dan-mills/microJect/injector driver 2/production/bom.csv

Designator | Footprint | Quantity | Value | LCSC Part #
C1, C19, C2, C20, C21, C3, C4, C5, C6, C7, C8 | 0603 | 11 | 1uF
C23, C25 | CP_Elec_5x5.7 | 2 | 22uF 35V
C27, C28, C34 | 0603 | 3 | 100nF
C29, C30, C31, C32 | 1206 | 4 | 10uF
C33 | 1206 | 1 | 10uF 50V
C9 | 1206 | 1 | 470pF 1kV
D10, D14, D4, D5, D6, D7, D8, D9 | 0603 | 8 | LED
D11, D12, D13, D15 | D_SOD-123 | 4 | B140HW-7
D16, D3 | SOT-23 | 2 | NUP2105L
IC3 | SOT89 | 1 | HT7533-1(SOT89)
IC4 | SOIC127P700X220-8N | 1 | ACPL-227-50BE
J1 | PHOENIX_1751109 | 1 | Conn_01x03_Socket
J10, J12, J7, J8, J9 | PHOENIX_1751099 | 5 | Conn_01x02_Pin
J2 | PinHeader_1x02_P2.54mm_Vertical | 1 | Conn_01x02
J3, J4 | PHOENIX_1751112 | 2 | Conn_01x04_Socket
J5 | PinHeader_1x06_P2.54mm_Vertical | 1 | Programming header
L3 | IND_MURATA-PS_4500 | 1 | 6.8uH
Q3, Q4, Q5, Q6 | SOT-23 | 4 | AO3400A
R1 | 1206 | 1 | 120R
R10, R11, R12, R15, R16, R19, R22, R28, R3, R4, R5, R6, R7, R8, R9 | 0603 | 15 | 10k
R17, R18 | 0603 | 2 | 4k7
R20, R21, R23, R29, R30, R31, R32 | 0603 | 7 | 1k
R27 | 0603 | 1 | 140k
SW1 | SW_DIPTRONICS_DHA-04TQ | 1 | Switch
TP1, TP2, TP3, TP4, TP5, TP6, TP7, TP8 | TestPoint_THTPad_2.5x2.5mm_Drill1.2mm | 8 | TestPoint
U1 | LQFP-32_7x7mm_P0.8mm | 1 | STM32F030K6Tx
U2 | Converter_DCDC_Murata_CRE1xxxxxx3C_THT | 1 | B2405S-1WR3
U4 | SOIC-16W_7.5x10.3mm_P1.27mm | 1 | ISO3082DW
U7 | SOT-583-8 | 1 | TPS62933
