dan-mills/microJect/injector driver 2/injector driver 2.kicad_pcb

## KiCad design injector driver 2/injector driver 2.kicad_pcb (2026-10-11)

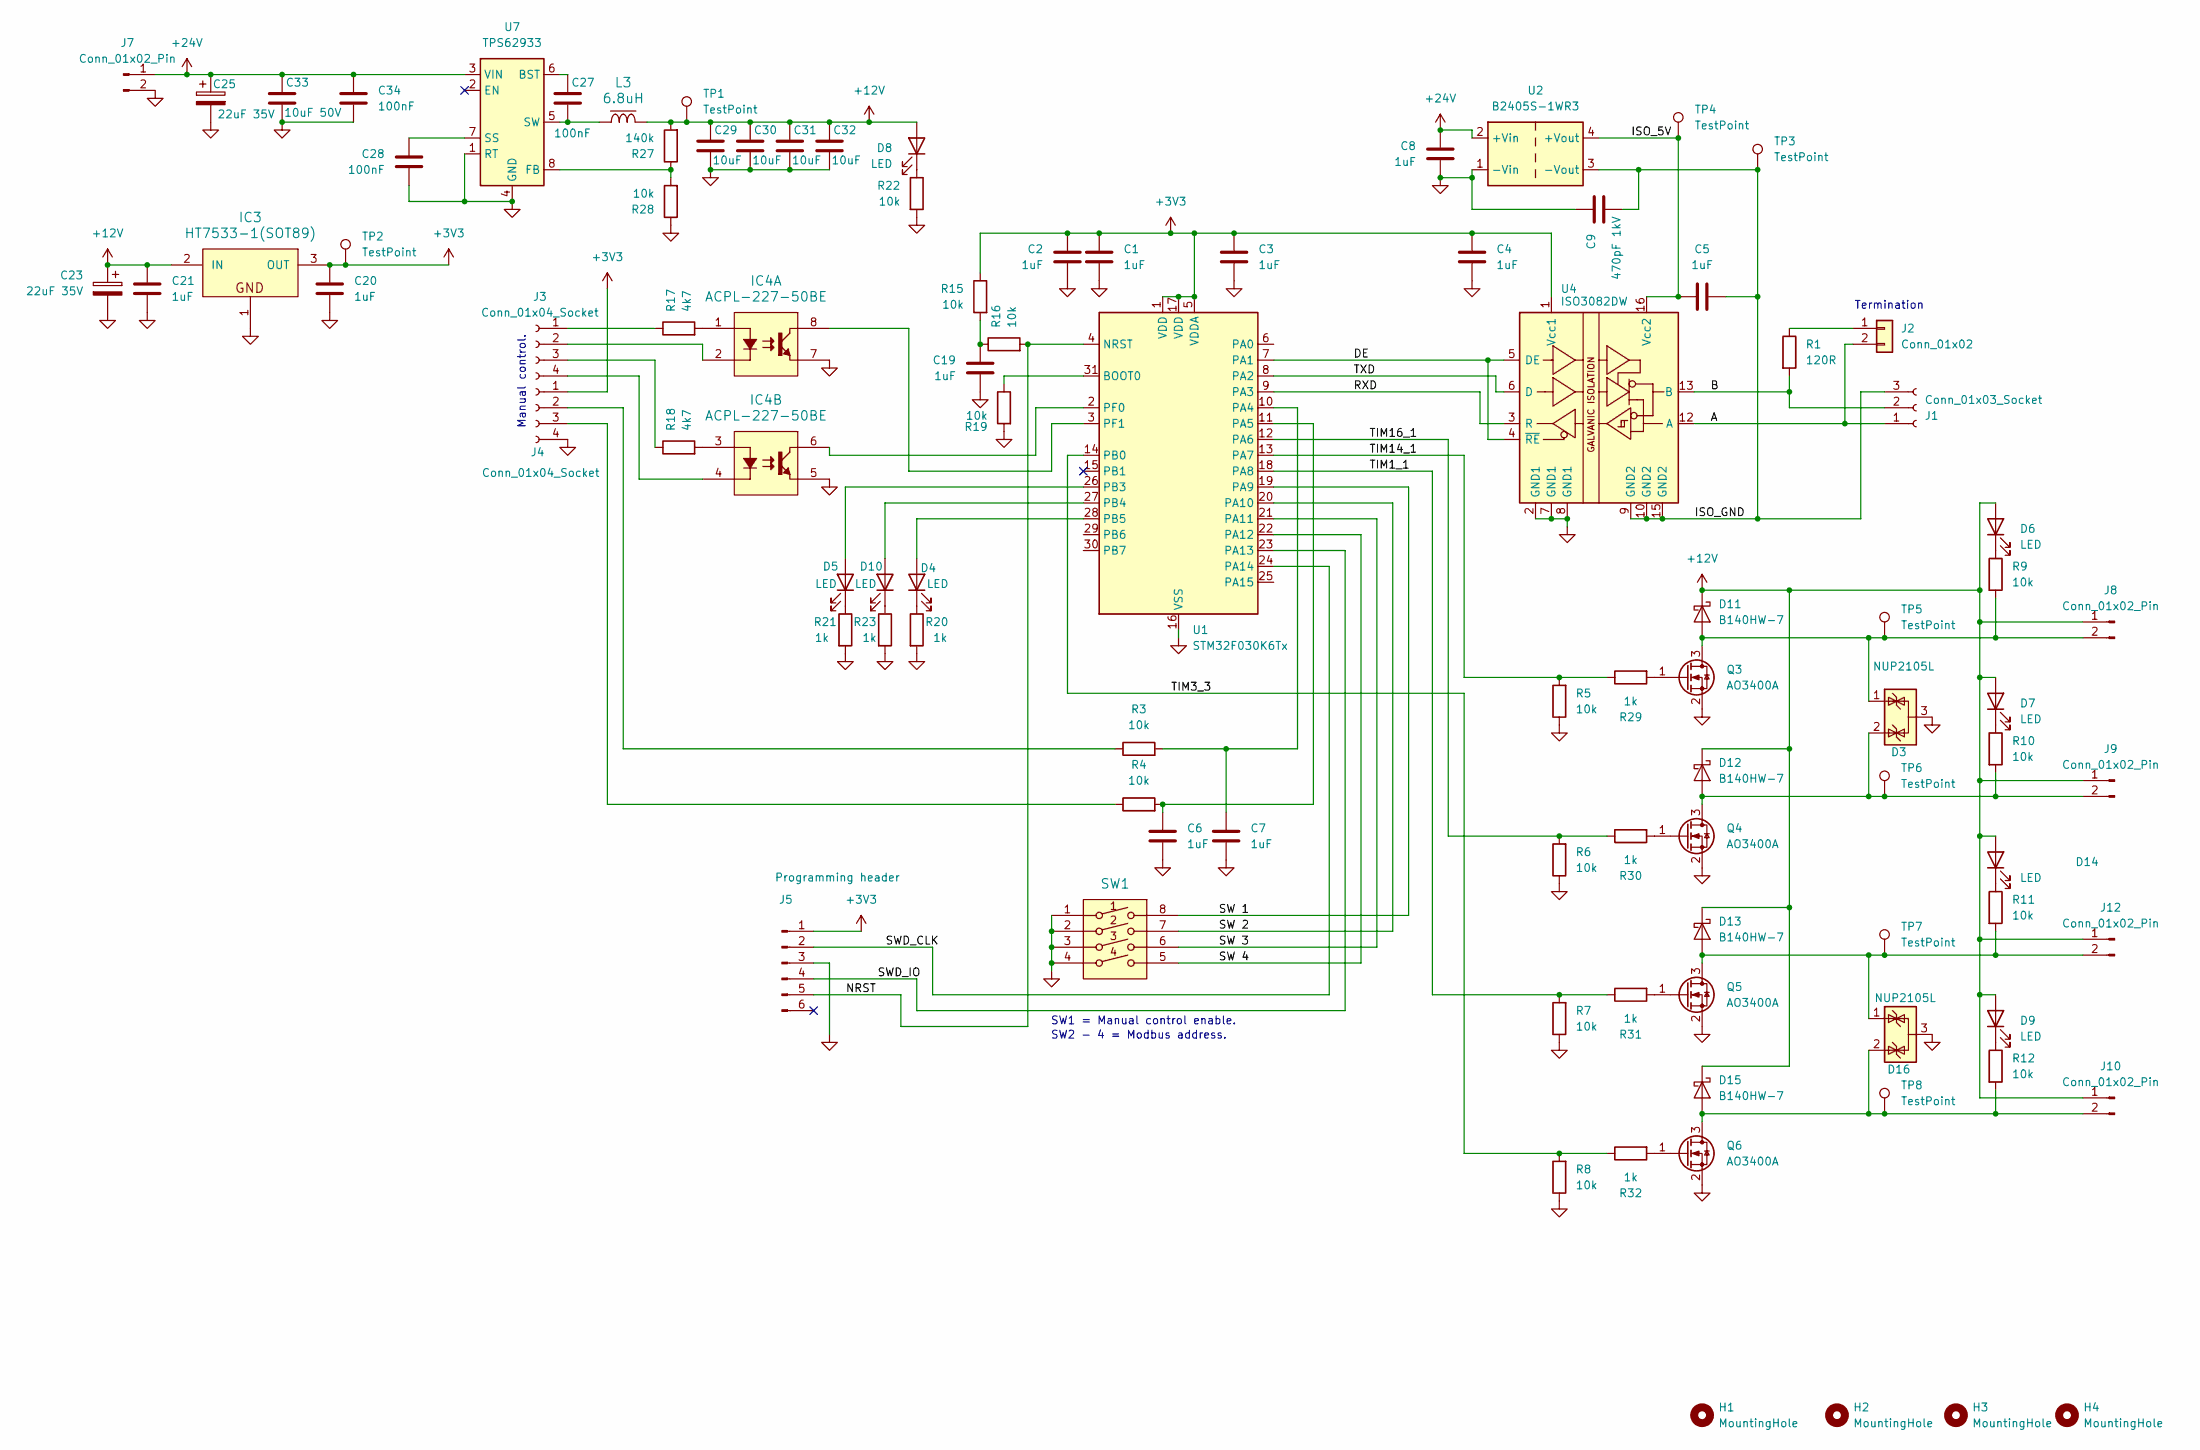
[picture p2: schematic injector driver 2.kicad_sch, Injector driver]

Parts:
C1, C2, C3, C4, C5, C6, C7, C8, C19, C20, C21: 1uF; C_0603_1608Metric
C9: 470pF 1kV; C_1206_3216Metric
C23, C25: 22uF 35V; CP_Elec_5x5.7
C27, C28, C34: 100nF; C_0603_1608Metric
C29, C30, C31, C32: 10uF; C_1206_3216Metric
C33: 10uF 50V; C_1206_3216Metric
D3, D16: NUP2105L; SOT-23
D4, D5, D6, D7, D8, D9, D10, D14: LED; LED_0603_1608Metric
D11, D12, D13, D15: B140HW-7; D_SOD-123; Part Number B140HW-7; JLCPCB ID C134429
H1, H2, H3, H4: MountingHole; MountingHole_3.2mm_M3_ISO14580_Pad
IC3: HT7533-1(SOT89); SOT89; Part Number HT7533-1(SOT89)
IC4: ACPL-227-50BE; SOIC127P700X220-8N; Part Description DC Input Dual Channel Half-Pitch Photot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
J1: Conn_01x03_Socket; PHOENIX_1751109
J2: Conn_01x02; PinHeader_1x02_P2.54mm_Vertical; Part Number 1-0201FBV0T
J3, J4: Conn_01x04_Socket; PHOENIX_1751112
J5: Programming header; PinHeader_1x06_P2.54mm_Vertical
J7, J8, J9, J10, J12: Conn_01x02_Pin; PHOENIX_1751099
L3: 6.8uH; IND_MURATA-PS_4500; Tolerance ±20%; Part Description Low Profile, High Current IHLP® Inductor
Q3, Q4, Q5, Q6: AO3400A; SOT-23
R1: 120R; R_1206_3216Metric
R3, R4, R5, R6, R7, R8, R9, R10, R11, R12, R15, R16, R19, R22, R28: 10k; R_0603_1608Metric
R17, R18: 4k7; R_0603_1608Metric
R20, R21, R23, R29, R30, R31, R32: 1k; R_0603_1608Metric
R27: 140k; R_0603_1608Metric
SW1: Switch; SW_DIPTRONICS_DHA-04TQ; Part Number SW_DIPTRONICS_DHA-04TQ
TP1, TP2, TP3, TP4, TP5, TP6, TP7, TP8: TestPoint; TestPoint_THTPad_2.5x2.5mm_Drill1.2mm
U1: STM32F030K6Tx; LQFP-32_7x7mm_P0.8mm
U2: B2405S-1WR3; Converter_DCDC_Murata_CRE1xxxxxx3C_THT
U4: ISO3082DW; SOIC-16W_7.5x10.3mm_P1.27mm
U7: TPS62933; SOT-583-8

Connections:
+3V3: C1.1, C2.1, C3.1, C4.1, C20.1, IC3.3 (OUT), J4.1, J5.1, R15.1, TP2.1 (1_1), U1.1 (VDD), U1.5 (VDDA), U1.17 (VDD), U4.1 (Vcc1)
+12V: C21.1, C23.1, C29.1, C30.1, C31.1, C32.1, D6.2 (A), D7.2 (A), D8.2 (A), D9.2 (A), D11.1 (K), D12.1 (K), D13.1 (K), D14.2 (A), D15.1 (K), IC3.2 (IN), J8.1, J9.1, J10.1, J12.1, L3.2, R27.2, TP1.1 (1_1)
+24V: C8.1, C25.1, C33.1, C34.1, J7.1, U2.2 (+Vin), U7.3 (VIN)
/A: J1.1, J2.2, U4.12 (A)
/B: J1.2, R1.2, U4.13 (B)
/DE: U1.7 (PA1), U4.4 (~RE), U4.5 (DE)
/ISO_5V: C5.1, TP4.1 (1_1), U2.4 (+Vout), U4.16 (Vcc2)
/ISO_GND: C5.2, C9.2, J1.3, TP3.1 (1_1), U2.3 (-Vout), U4.9 (GND2), U4.10 (GND2), U4.15 (GND2)
/NRST: J5.5, R16.2, U1.4 (NRST)
/RXD: U1.9 (PA3), U4.3 (R)
/SW 1: SW1.8, U1.19 (PA9)
/SW 2: SW1.7, U1.20 (PA10)
/SW 3: SW1.6, U1.21 (PA11)
/SW 4: SW1.5, U1.22 (PA12)
/SWD_CLK: J5.2, U1.24 (PA14)
/SWD_IO: J5.4, U1.23 (PA13)
/TIM1_1: R7.2, R31.1, U1.18 (PA8)
/TIM3_3: R8.2, R32.1, U1.14 (PB0)
/TIM14_1: R5.2, R29.1, U1.13 (PA7)
/TIM16_1: R6.2, R30.1, U1.12 (PA6)
/TXD: U1.8 (PA2), U4.6 (D)
GND: C1.2, C2.2, C3.2, C4.2, C6.2, C7.2, C8.2, C9.1, C19.2, C20.2, C21.2, C23.2, C25.2, C28.2, C29.2, C30.2, C31.2, C32.2, C33.2, C34.2, D3.3 (A), D16.3 (A), IC3.1 (GND), IC4.5 (E), IC4.7 (E), J4.4, J5.3, J7.2, Q3.2 (S), Q4.2 (S), Q5.2 (S), Q6.2 (S), R5.1, R6.1, R7.1, R8.1, R19.2, R20.2, R21.2, R22.2, R23.2, R28.1, SW1.1, SW1.2, SW1.3, SW1.4, U1.16 (VSS), U1.32 (VSS), U2.1 (-Vin), U4.2 (GND1), U4.7 (GND1), U4.8 (GND1), U7.1 (RT), U7.4 (GND)
unnamed: C19.1, R15.2, R16.1
unnamed: D4.2 (A), U1.28 (PB5)
unnamed: D4.1 (K), R20.1
unnamed: D5.2 (A), U1.26 (PB3)
unnamed: D5.1 (K), R21.1
unnamed: D6.1 (K), R9.1
unnamed: D7.1 (K), R10.1
unnamed: D8.1 (K), R22.1
unnamed: D9.1 (K), R12.1
unnamed: D10.2 (A), U1.27 (PB4)
unnamed: D10.1 (K), R23.1
unnamed: D3.1 (K), D11.2 (A), J8.2, Q3.3 (D), R9.2, TP5.1 (1_1)
unnamed: D3.2 (K), D12.2 (A), J9.2, Q4.3 (D), R10.2, TP6.1 (1_1)
unnamed: D13.2 (A), D16.1 (K), J12.2, Q5.3 (D), R11.2, TP7.1 (1_1)
unnamed: D14.1 (K), R11.1
unnamed: D15.2 (A), D16.2 (K), J10.2, Q6.3 (D), R12.2, TP8.1 (1_1)
unnamed: IC4.1 (A), R17.2
unnamed: IC4.8 (C), U1.3 (PF1)
unnamed: IC4.2 (K), J3.2
unnamed: IC4.3 (A), R18.2
unnamed: IC4.6 (C), U1.2 (PF0)
unnamed: IC4.4 (K), J3.4
unnamed: J2.1, R1.1
unnamed: J3.1, R17.1
unnamed: J3.3, R18.1
unnamed: J4.2, R3.1
unnamed: J4.3, R4.1
unnamed: Q3.1 (G), R29.2
unnamed: Q4.1 (G), R30.2
unnamed: Q5.1 (G), R31.2
unnamed: Q6.1 (G), R32.2
unnamed: R19.1, U1.31 (BOOT0)
unnamed: C7.1, R3.2, U1.10 (PA4)
unnamed: C6.1, R4.2, U1.11 (PA5)
unnamed: C27.1, U7.6 (BST)
unnamed: R27.1, R28.2, U7.8 (FB)
unnamed: C28.1, U7.7 (SS)
unnamed: C27.2, L3.1, U7.5 (SW)

Notes on the sheet:
SW1 = Manual control enable.
Termination
Manual control.
SW2 - 4 = Modbus address.

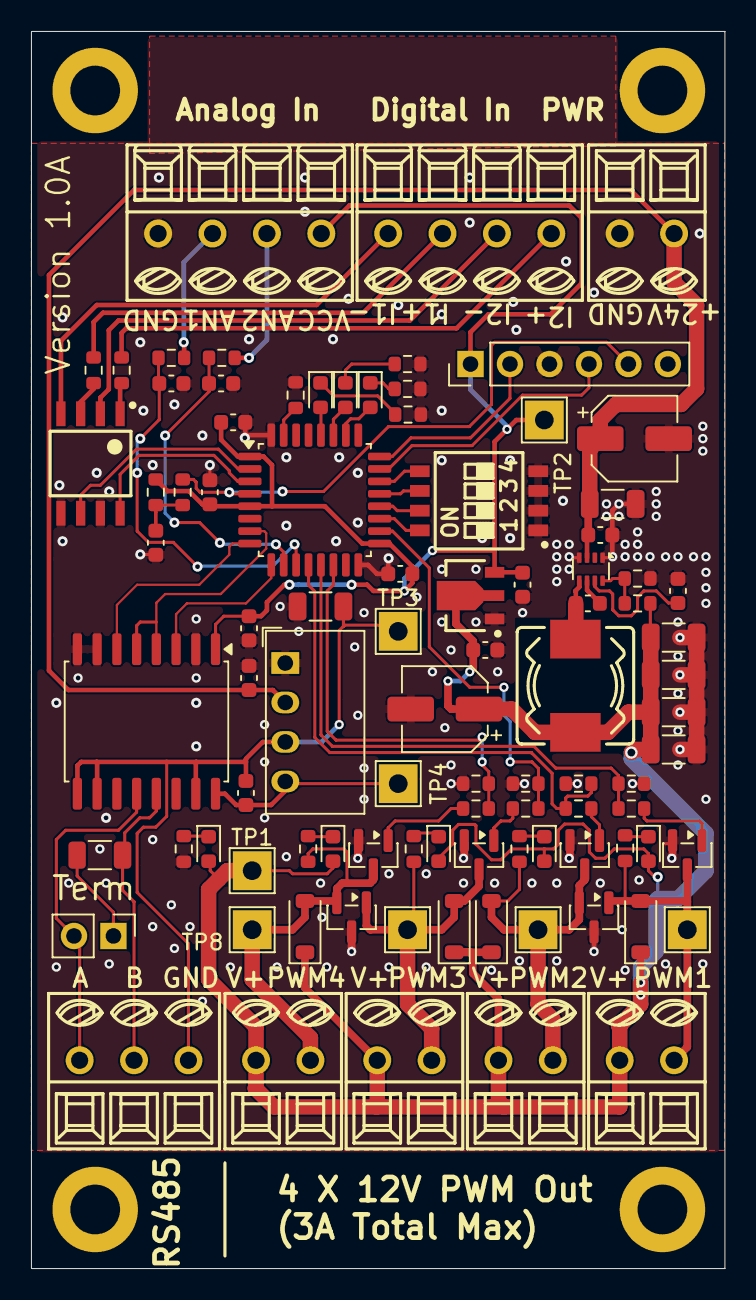
[picture p3: board injector driver 2.kicad_pcb from above]

Board: 2 copper layers, 44.6 x 79.6 mm, 96 parts (0 on the bottom side), 60 nets.
