dan-mills/microJect/(commit log)

2026-10-03 Added loss of comms timeout and first cut at system info PDU
2026-10-03 Added CPU, Modbus error and modbus data leds
    [main.rs]
2026-10-04 DMA ringbuffer on the uart so we can now keep up at full 115200 baud
2026-10-09 Software timing now, the hardware version was annoying. Fixed bug in modbus write registers that was writing to the wrong ones.
    [main.rs]
2026-10-11 moved hardware projectin into this directory, moved the firmware into the firmware directory
    [bom.csv, designators.csv, injector driver 2.kicad_pcb, injector driver 2.kicad_sch, injector driver.kicad_sch, positions.csv]
2026-10-11 removed backup kicad files
2026-10-12 Fixed a whole pile of clippy lints
    [modbus.rs]
2026-10-12 added a Graphics directory and tweaked .gitignore
    [injector driver.kicad_sch]
2026-10-12 Enhance README with control and power details
    Added additional details about control, power input, and firmware.
2026-10-17 Fixed up analogue inputs so they work in a sane way in manual mode
    [main.rs]
